bashir-abdelwahed/TFC-NXP-Lebanon/(commit log)

2021-04-05 adding camera_test directory
2021-04-05 adding sketch to visualize the camera using processing
